ramesh424/Smart-Grow-Chamber/Data/processed outputs/Result Image.png

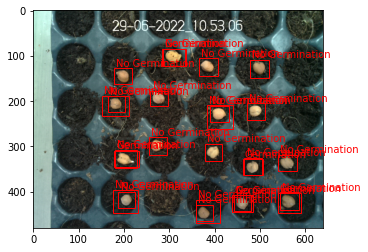
Data/processed outputs/Result Image.png
