ramesh424/Smart-Grow-Chamber/Data/processed outputs/result 2.png

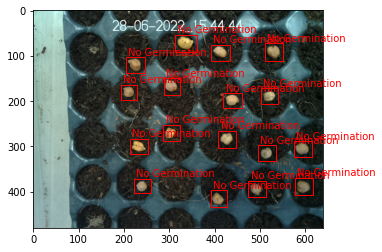
Data/processed outputs/result 2.png
