ramesh424/Smart-Grow-Chamber/Data/processed outputs/WhatsApp Image 2026-05-13 at 3.35.42 PM.jpeg

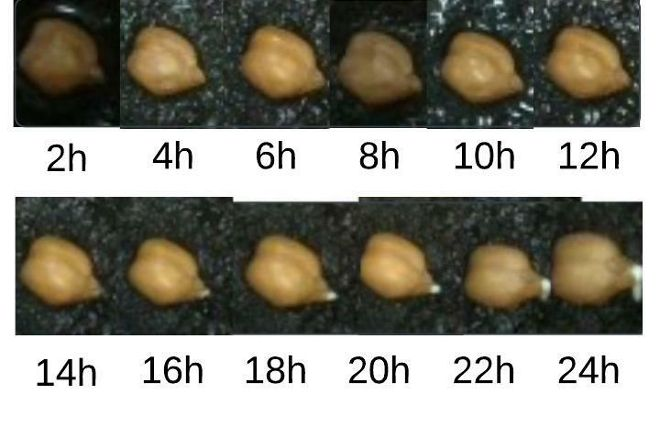
Data/processed outputs/WhatsApp Image 2026-05-13 at 3.35.42 PM.jpeg
