ramesh424/Smart-Grow-Chamber/Data/processed outputs/WhatsApp Image 2026-05-25 at 1.09.51 PM.jpeg

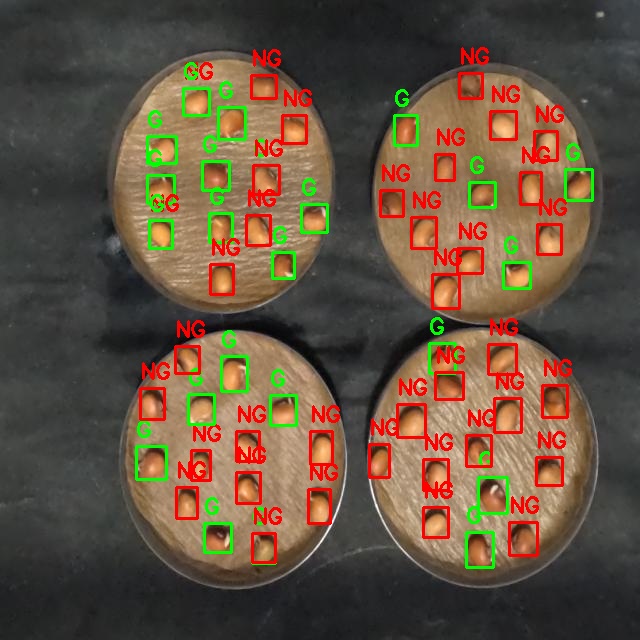
Data/processed outputs/WhatsApp Image 2026-05-25 at 1.09.51 PM.jpeg
