ramesh424/Smart-Grow-Chamber/Data/sample_images/6n7q2u (1).gif

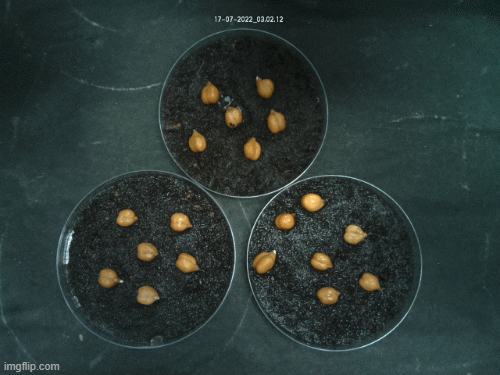
Data/sample_images/6n7q2u (1).gif
