ramesh424/Smart-Grow-Chamber/Hardware/Wiring/wiring diagram.pdf

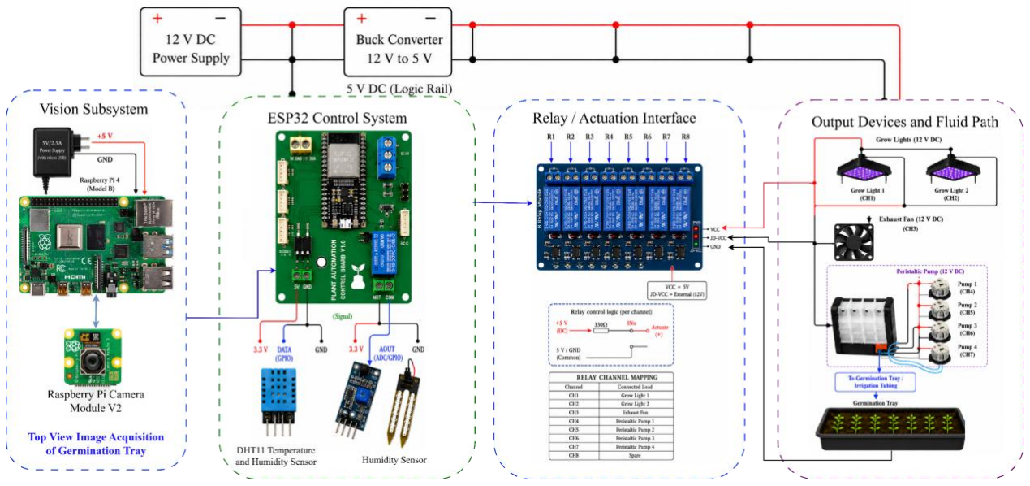
[picture p6: figure]
