ramesh424/Smart-Grow-Chamber/(commit log)

2026-05-13 Rename Doc1.pdf to Hardware/Wiring/wiring diagram.pdf
2026-05-13 Rename wiring diagram.jpg to Hardware/Wiring/wiring diagram.png
2026-05-26 Rename WhatsApp Image 2026-05-11 at 6.33.10 PM.jpeg to sample images
2026-05-26 Rename WhatsApp Image 2026-05-13 at 3.35.43 PM.jpeg to sample images 1
2026-05-26 Rename WhatsApp Image 2026-05-25 at 1.10.06 PM.jpeg to sample images2
