ramesh424/Smart-Grow-Chamber/(notices)

Notices in the files:
README.md:
License: CERN-OHL-W 2.0 | MIT
